Mahaadevan/Arduino_Keyboard_-74HC595/hardware/Keyboard_Mapping.xlsx

Row | Column | Normal Value | Shift Layer / NumLock Off | Section
7 | 1 | esc |  | fn key row
6 | 1 | f1 |  | fn key row
7 | 2 | f2 |  | fn key row
6 | 2 | f3 |  | fn key row
1 | 0 | f4 |  | fn key row
7 | 4 | f5 |  | fn key row
7 | 15 | f6 |  | fn key row
7 | 12 | f7 |  | fn key row
6 | 10 | f8 |  | fn key row
0 | 10 | f9 |  | fn key row
0 | 9 | f10 |  | fn key row
1 | 10 | f11 |  | fn key row
5 | 10 | f12 |  | fn key row
7 | 17 | print screen/Sys rq |  | misc keys
6 | 17 | scroll lock |  | misc keys
1 | 8 | pause/break |  | misc keys
4 | 5 | insert |  | misc keys
7 | 6 | home |  | misc keys
4 | 11 | page up |  | misc keys
5 | 5 | delete |  | misc keys
5 | 11 | end |  | misc keys
3 | 11 | page down |  | misc keys
7 | 16 | up arrow |  | misc keys
0 | 12 | left arrow |  | misc keys
0 | 11 | down arrow |  | misc keys
6 | 12 | right arrow |  | misc keys
0 | 0 | ` | ~ | main keys
5 | 1 | 1 | ! | main keys
5 | 1 | 2 | @ | main keys
4 | 2 | 3 | # | main keys
5 | 17 | 4 | $ | main keys
4 | 17 | 5 | % | main keys
6 | 15 | 6 | ^ | main keys
5 | 15 | 7 | & | main keys
5 | 6 | 8 | * | main keys
4 | 6 | 9 | ( | main keys
5 | 4 | 0 | ) | main keys
4 | 3 | - | _ | main keys
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
