Mahaadevan/Arduino_Keyboard_-74HC595/docs/images/74HC595-pinout.webp

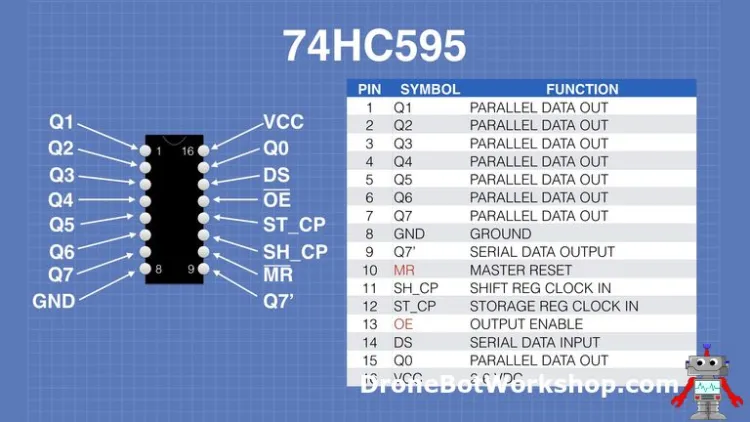
docs/images/74HC595-pinout.webp
