Mahaadevan/Arduino_Keyboard_-74HC595/docs/images/Arduino-Pro-Micro-Pinout.webp

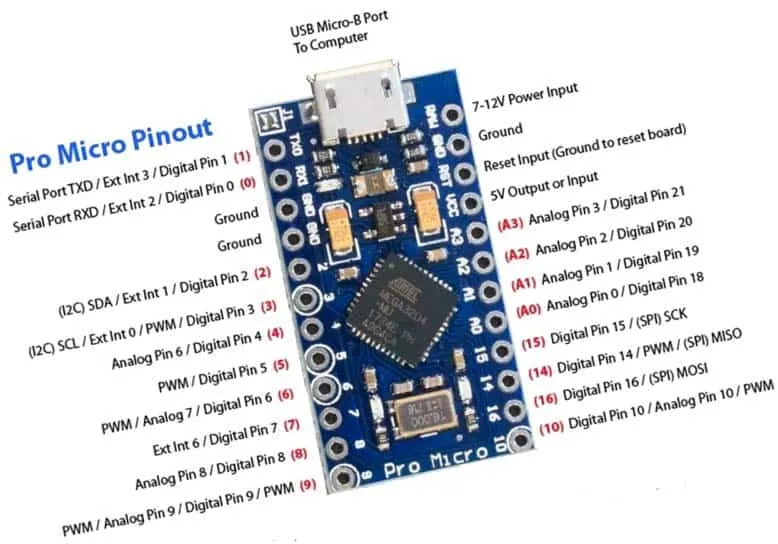
docs/images/Arduino-Pro-Micro-Pinout.webp
