Mahaadevan/Arduino_Keyboard_-74HC595/docs/photos/01-samsung-sdm4500p-label.png

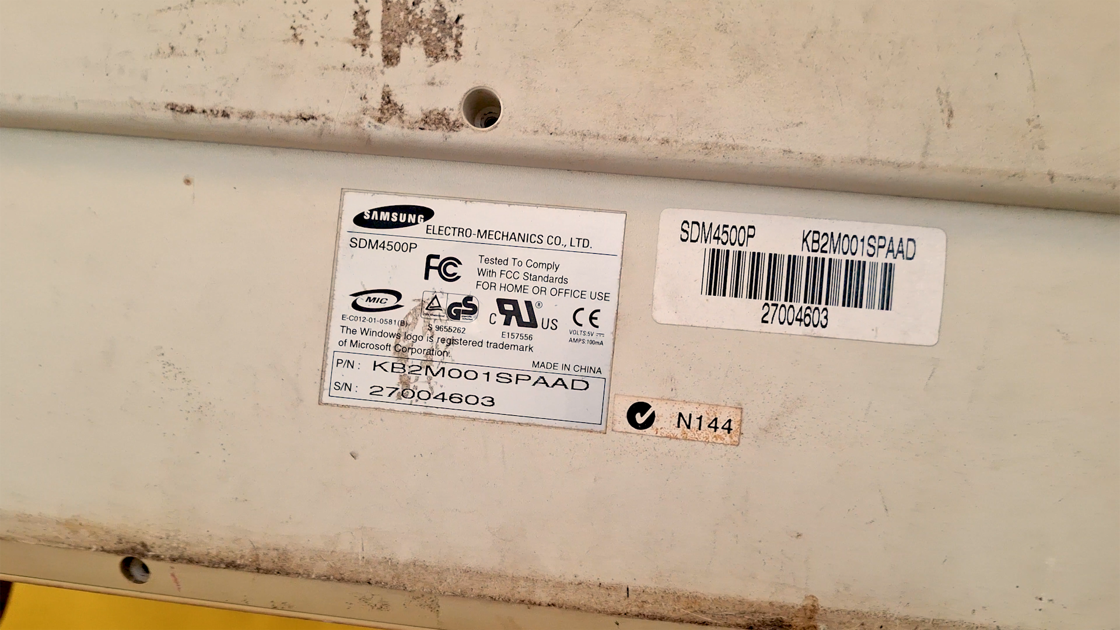
docs/photos/01-samsung-sdm4500p-label.png
