Mahaadevan/Arduino_Keyboard_-74HC595/docs/photos/03-original-sdm4500p-controller-ic.png

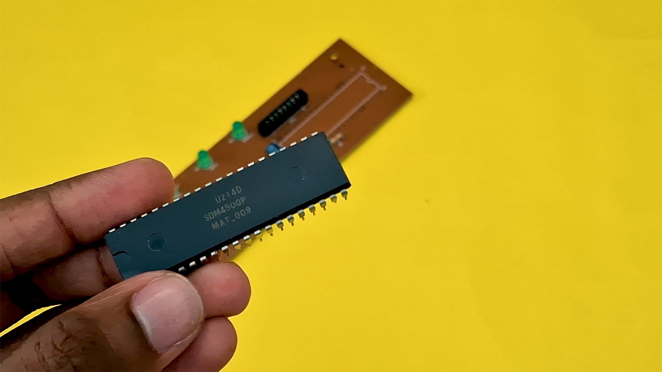
docs/photos/03-original-sdm4500p-controller-ic.png
