Mahaadevan/Arduino_Keyboard_-74HC595/docs/photos/04-original-controller-ic-closeup.png

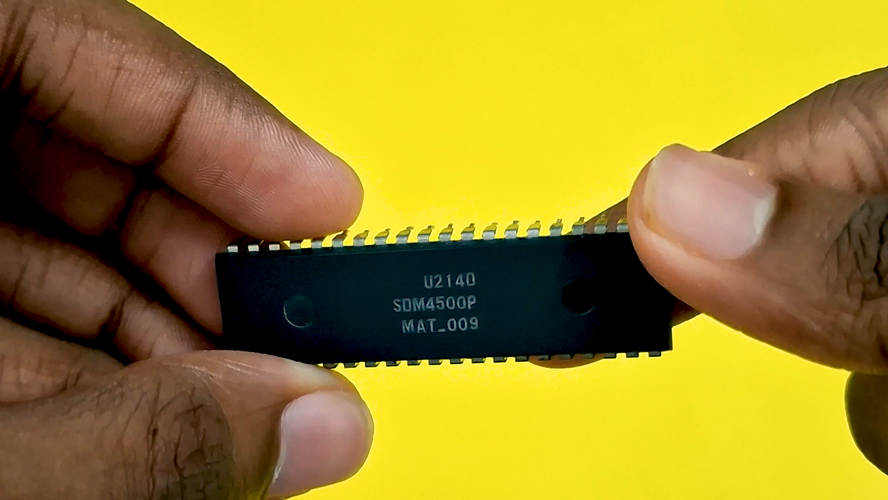
docs/photos/04-original-controller-ic-closeup.png
