Mahaadevan/Arduino_Keyboard_-74HC595/docs/photos/02-membrane-pcb-solder-pads.png

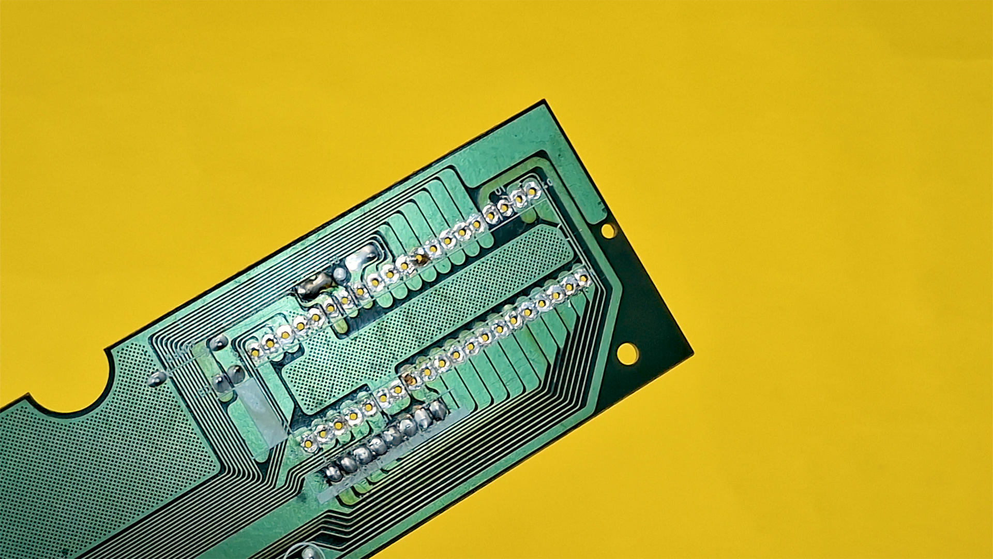
docs/photos/02-membrane-pcb-solder-pads.png
