Mahaadevan/Arduino_Keyboard_-74HC595/docs/photos/07-finished-keyboard-test.png

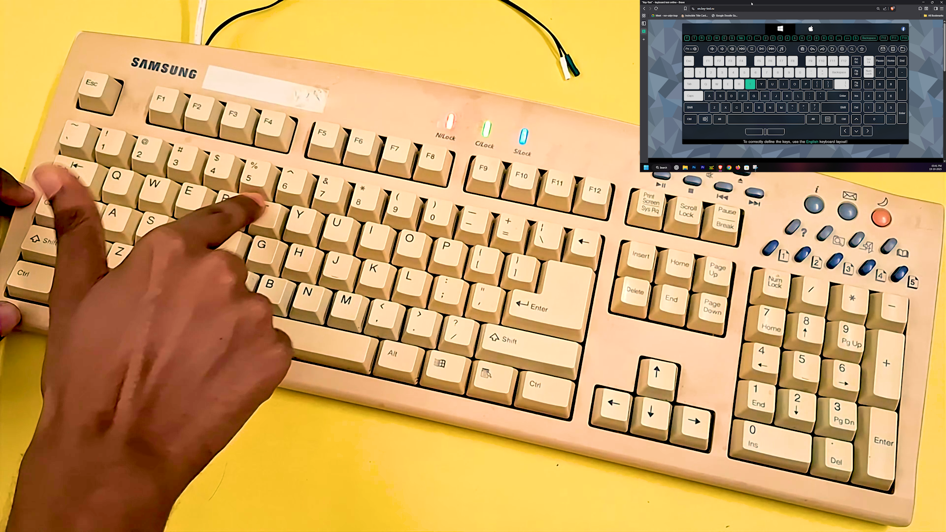
docs/photos/07-finished-keyboard-test.png
